Z-b0101/zb-flight-model/program/MASS_ROLLUP.md

# Stacked mass / CG / SM roll-up (CE-01 freeze input)

Generated by `scripts/mass_rollup.py` from `cad/params.json` (design + structure blocks). **Mass baseline locked (proposed): 211.9 g planning, CG 128.5 mm.** NP 142.56 mm (twin VLM, as computed by the script; every SM in this file comes from the script). Static-margin floor 5.0%; band 5–8%.

## Case 1: all changes + a 17 g motor, no trim levers

| Step | Mass (g) | CG (mm) | SM |
| --- | --- | --- | --- |
| Planning baseline (locked) | 211.9 | 128.50 | 7.03% |
| R2 hinge-line web | 212.7 | 128.95 | 6.81% |
| R3 mid-chord web | 214.2 | 129.53 | 6.52% |
| Web glue | 214.7 | 129.77 | 6.40% |
| R4 hatch frame/tray/lid (net) | 216.2 | 129.15 | 6.70% |
| R5 centre section (net) | 217.7 | 128.81 | 6.87% |
| DR-01 tip fins | 219.7 | 131.10 | 5.73% |
| Motor delta (17 g vs 10 g) | 226.7 | 132.98 | 4.79% **below 5% floor** |

## Case 2: same + battery 3 mm forward (current hatch limit) + ESC moved next to the FC (185 → 95 mm)

| Step | Mass (g) | CG (mm) | SM |
| --- | --- | --- | --- |
| Planning baseline (locked) | 211.9 | 128.50 | 7.03% |
| R2 hinge-line web | 212.7 | 128.95 | 6.81% |
| R3 mid-chord web | 214.2 | 129.53 | 6.52% |
| Web glue | 214.7 | 129.77 | 6.40% |
| R4 hatch frame/tray/lid (net) | 216.2 | 129.15 | 6.70% |
| R5 centre section (net) | 217.7 | 128.81 | 6.87% |
| DR-01 tip fins | 219.7 | 131.10 | 5.73% |
| Motor delta (17 g vs 10 g) | 226.7 | 132.98 | 4.79% **below 5% floor** |
| Battery 3 mm forward | 226.7 | 132.16 | 5.20% |
| ESC moved to 95 mm | 226.7 | 130.77 | 5.90% |

## Sensitivity: final SM vs motor mass (with both levers)

| Motor mass (g) | AUW (g) | CG (mm) | SM |
| --- | --- | --- | --- |
| 10 | 219.7 | 128.82 | 6.87% |
| 12 | 221.7 | 129.39 | 6.59% |
| 14 | 223.7 | 129.95 | 6.31% |
| 17 | 226.7 | 130.77 | 5.90% |
| 19 | 228.7 | 131.30 | 5.63% |
| 20 | 229.7 | 131.57 | 5.50% |
| 25 | 234.7 | 132.86 | 4.85% |

**Reading:** without trim levers, a 17 g motor takes SM below the 5% floor (4.79%). Moving the battery 3 mm forward and relocating the ESC next to the FC restores 5.90%. Rule for the R-07 pick: stacked SM ≥ 5.5% using only those two levers, i.e. motor ≤ 19 g strictly (20 g gives 5.496%, just under the line). Ballast is a last resort. MBSE records the acceptance at CE-01.

**Correction (2026-10-14, MBSE independent verification):** the sensitivity table was earlier hand-computed with NP 142.6 mm. It is now regenerated from the script (NP 142.56 mm): about −0.02 points across the column, and 20 g gives 5.496% (shown rounded as 5.50%), not 5.52%.

**Superseded for the R-07 pick:** the motor-only cap above does not include the prop, the prop adapter or the DR-14 notch. The full R-07 power-train stack gives SM 4.58% with both levers and needs a CG lever. See `mfg/MOTOR_TRADE.md` §6 on `r07/motor-trade` (PR #14).
