Z-b0101/zb-flight-model/program/README.md

# Z!B Program — System of Record

This folder holds the program's controlled documents — the files the Z!B team
actually runs on. Pushed 2026-10-13 by Oubi (outgoing GM) per CEO direction,
as part of the acting-GM handover to Claude.

**Start here:** `DEV_TRACKER.md` — the system of record. Everything else hangs off it.
**Document register:** `ZIB_DOCUMENT_REGISTER.md` — what each file is, who owns it, its status.

| File | What it is |
|---|---|
| DEV_TRACKER.md | System of record: decisions, work packages, gates, open items |
| DESIGN_PHILOSOPHY.md | The 8 principles the program runs on |
| RISK_REGISTER.md | 15 open risks + mitigations (living) |
| WEIGHT_BUDGET.md | Gram-by-gram budget; 46g margin (living) |
| BUDGET.md | $10K program budget, phased spend (living) |
| CE_COLLABORATION_PROCESS.md | Inbox protocol (authorship lines, tags, SLA) |
| ZIB_DOCUMENT_REGISTER.md | Register of all program documents |
| AIRFOIL_TRADE.md | MH60 selection study |
| ITERATION_LOG.md | A2 optimization loop (4 cycles, converged) |
| GITHUB_TRACEABILITY.md | 40-claim audit: 55% backed / 40% partial / 5% gap |
| AERO_OPTIMIZATION.md | Aero optimization study |
| AIRFRAME_ARCHITECTURES.md | 16-source architecture survey |
| MATERIALS.md | Materials audit |
| HOTEL_LOAD_PLAN.md | Hotel-load measurement plan |
| VERIFICATION_MATRIX.md | Requirements → verification (26 RQs, DAL E) |
| TDR_RECORD.md | Twin Design Review record (verdict: proceed with actions) |
| FHA.md | Functional Hazard Assessment (ARP4761-lite, 5J envelope) |
| DESIGN_CLOSURE.md | Design closure record |
| MBSE_FRAMEWORK.md | Model-based systems engineering framework |
| SAE_ALIGNMENT.md | ARP4754A tailoring alignment |
| WILD_CONCEPTS.md | E1/E2/E3 concept proposals |
| ZIB_MASTER_PACKAGE.md | Distributable snapshot (draft) |
| ZIB_OPERATING_SYSTEM.md | Behavior handbook (CEO-held) |
| reviews/INHERITED_BASELINE_AUDIT_2026-10-13.md | Y3k's Day 1–2 baseline audit |

**Rules:** These files are the truth. Update them in place; never rewrite history
(DEV_TRACKER is append-only). The handover narrative + program-system YAML live
with the CEO, not here — this folder is the evidence, not the story.
