Z-b0101/zb-flight-model/program/handover/README.md

# Handover notes (Constitution Art III.6)

Written by the STF (`[STF — Claude]`) for each specialist seat.

Every note covers four things:
- the decisions in that lane
- the reasons behind them
- the traps already hit
- where the evidence lives (commit refs)

Notes are kept current. A note is a teaching record, not a design record. The frozen design is `cad/params.json` @ hash `479399d88b60`.

| Seat | Note | Status |
|---|---|---|
| AERO | `AERO.md` | Due 2026-10-15, 08:30 PT |
| ME | `ME.md` | Due 2026-10-15, 08:30 PT |
| SCM/MFG | `SCM_MFG.md` | Due 2026-10-15, 08:30 PT |
| CS | `CS.md` | Due 2026-10-15, 12:00 PT |
| PM | `PM.md` | Due 2026-10-15, 12:00 PT |
| BIZ | `BIZ.md` (the numbers: what is measured, modelled or provisional) | Due 2026-10-15, 12:00 PT |
| HR | `HR.md` (seats, tags, access history) | Due 2026-10-15, 12:00 PT |
