Z-b0101/zb-flight-model/reports/ZB-ER-001/figures/A-4.png

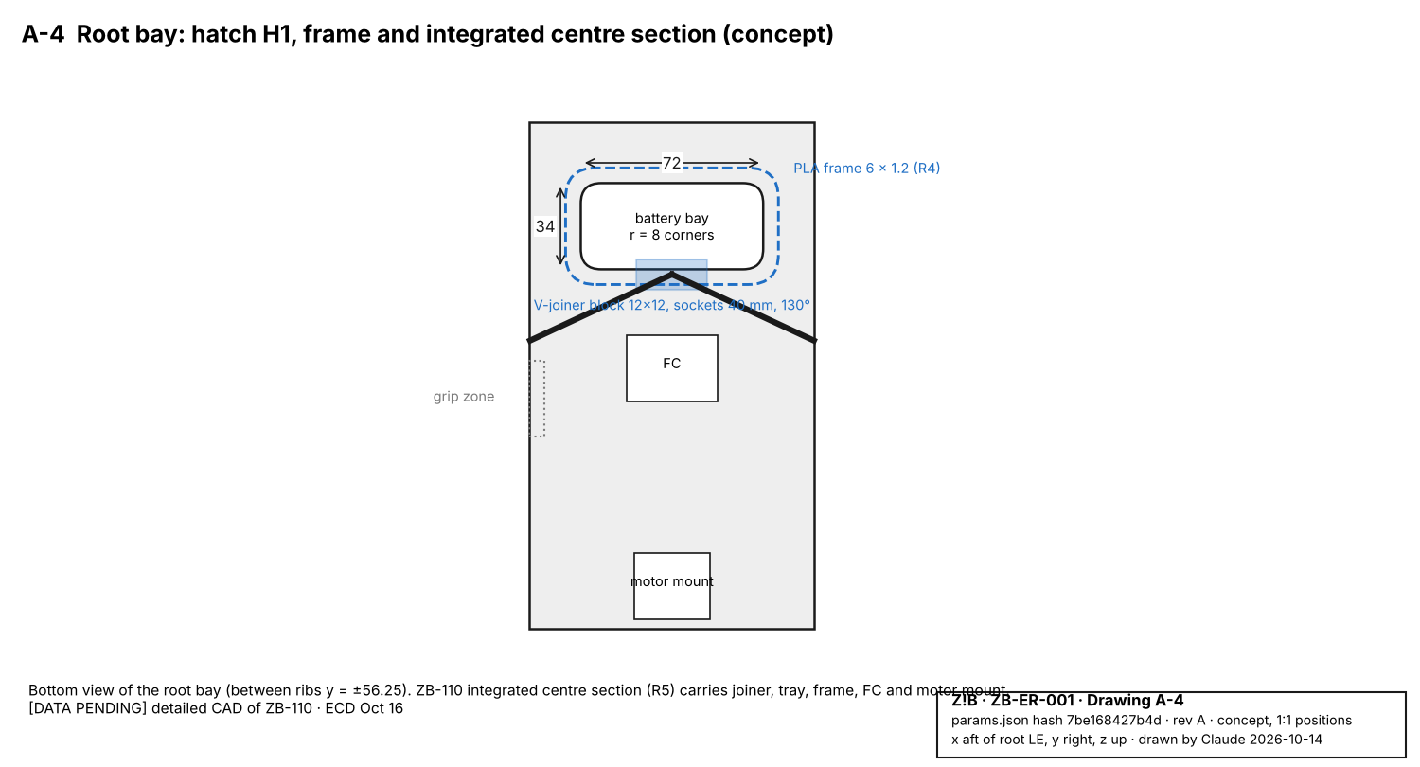
reports/ZB-ER-001/figures/A-4.png
