Z-b0101/zb-flight-model/reports/ZB-ER-001/figures/B-3.png

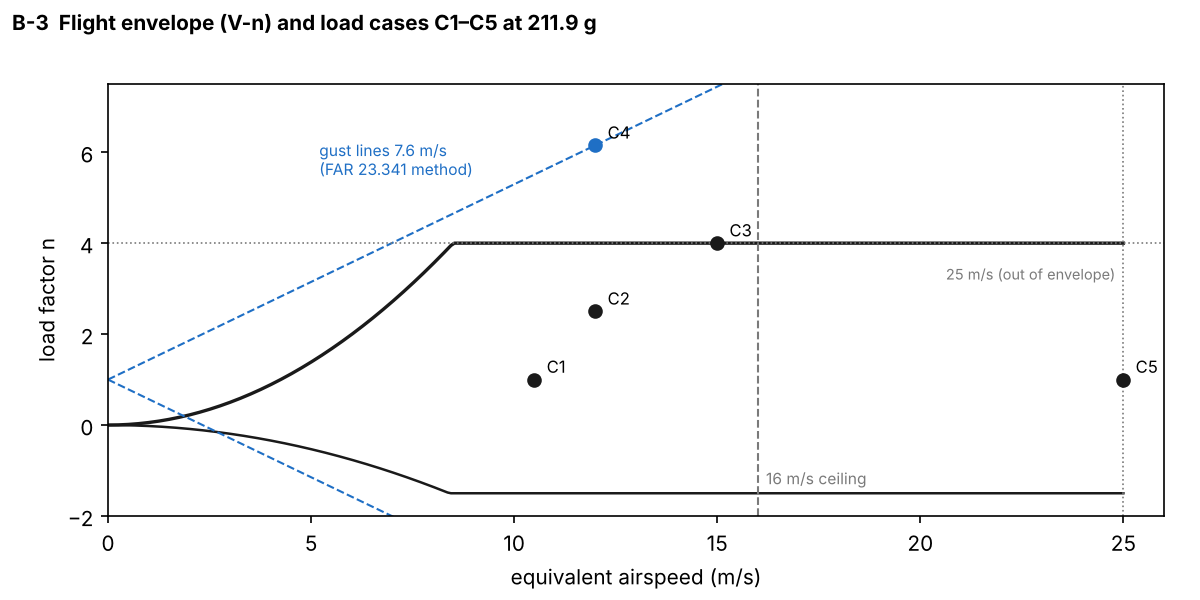
reports/ZB-ER-001/figures/B-3.png
