Z-b0101/zb-flight-model/cad/assembly.stl

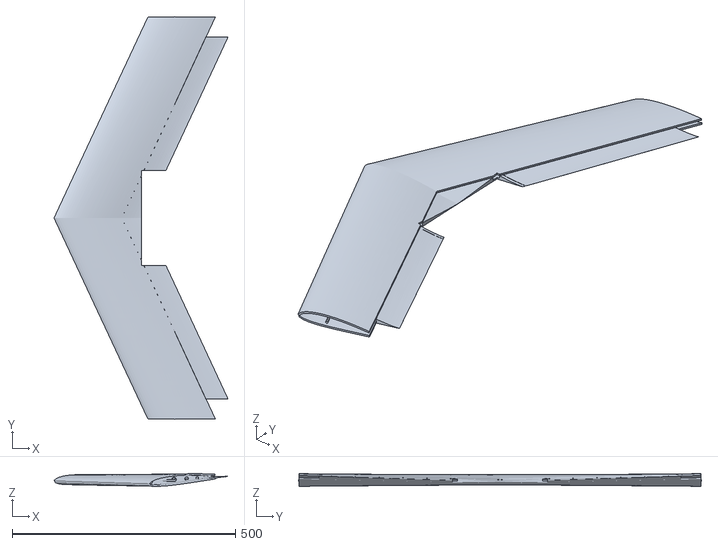
[picture p24: CAD file, 2026-10-15]
cad/assembly.stl
389.7 x 902.7 x 28.4
