Z-b0101/zb-flight-model/cad/assembly_full.stl

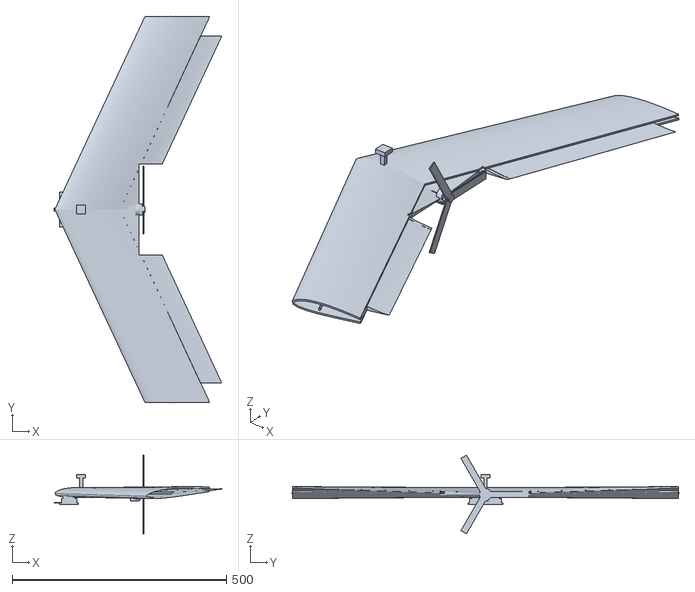
[picture p25: CAD file, 2026-10-15]
cad/assembly_full.stl
391.3 x 902.7 x 183.5
