Z-b0101/zb-flight-model/cad/parts/avionics/rx.stl

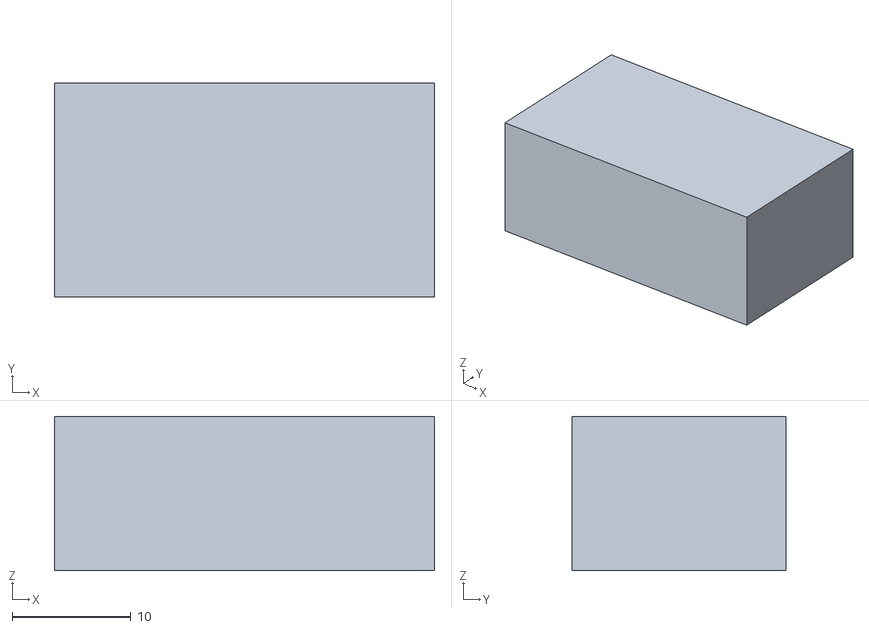
[picture p26: CAD file, 2026-10-15]
cad/parts/avionics/rx.stl
32.0 x 18.0 x 13.0
