Z-b0101/zb-flight-model/cad/parts/hatch/tray_port.stl

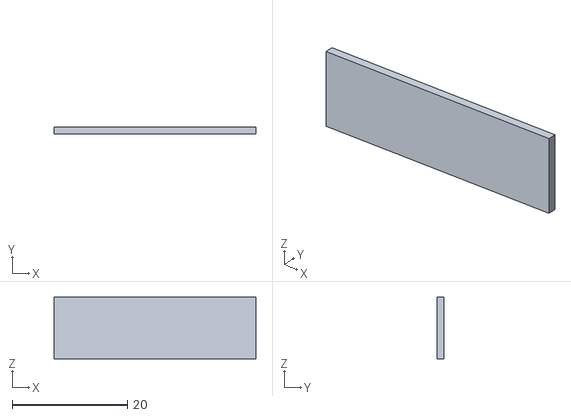
[picture p27: CAD file, 2026-10-15]
cad/parts/hatch/tray_port.stl
35.0 x 1.20 x 10.7
