Z-b0101/zb-flight-model/cad/parts/power/battery.stl

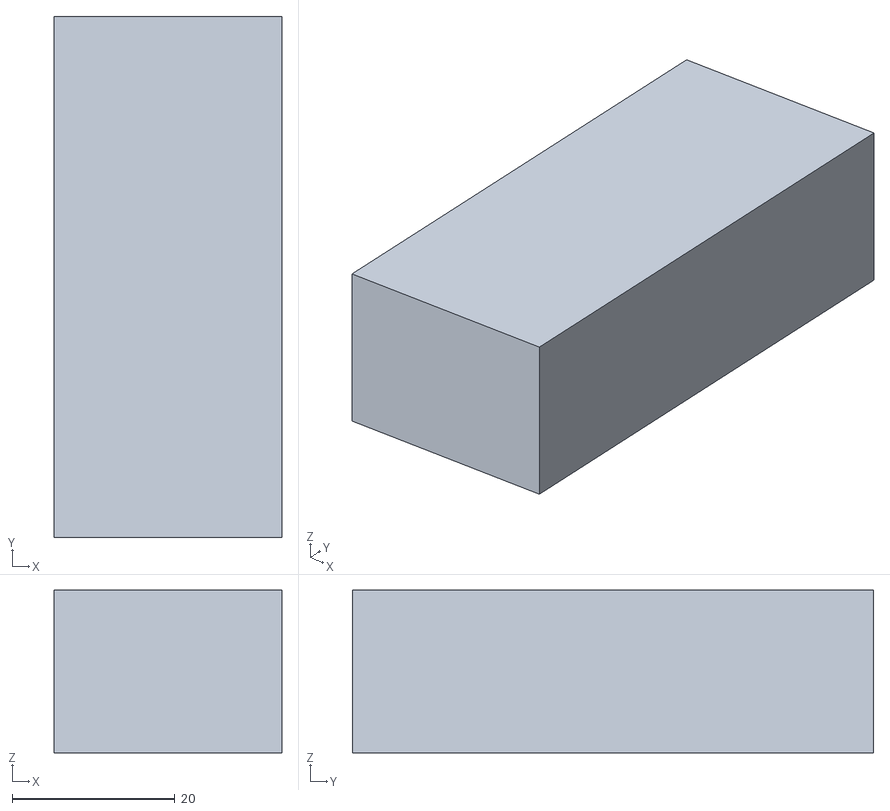
[picture p28: CAD file, 2026-10-15]
cad/parts/power/battery.stl
28.0 x 64.0 x 20.0
