Z-b0101/zb-flight-model/cad/parts/propulsion/propulsion.stl

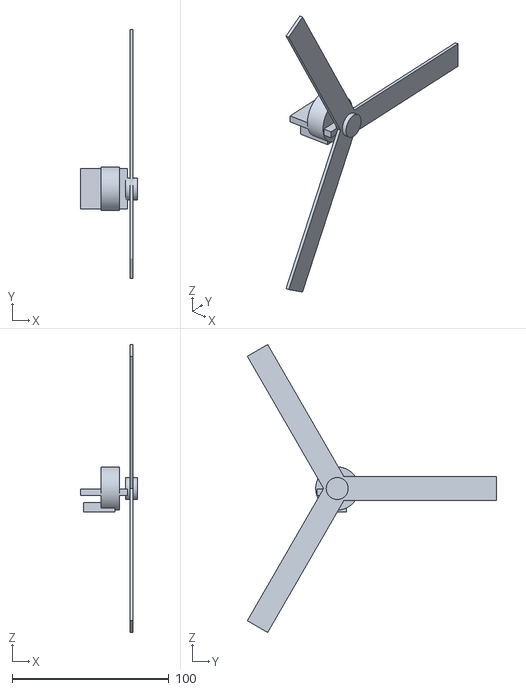
[picture p29: CAD file, 2026-10-15]
cad/parts/propulsion/propulsion.stl
36.4 x 158.9 x 183.5
