Z-b0101/zb-flight-model/cad/parts/wing_structure/skin_top.stl

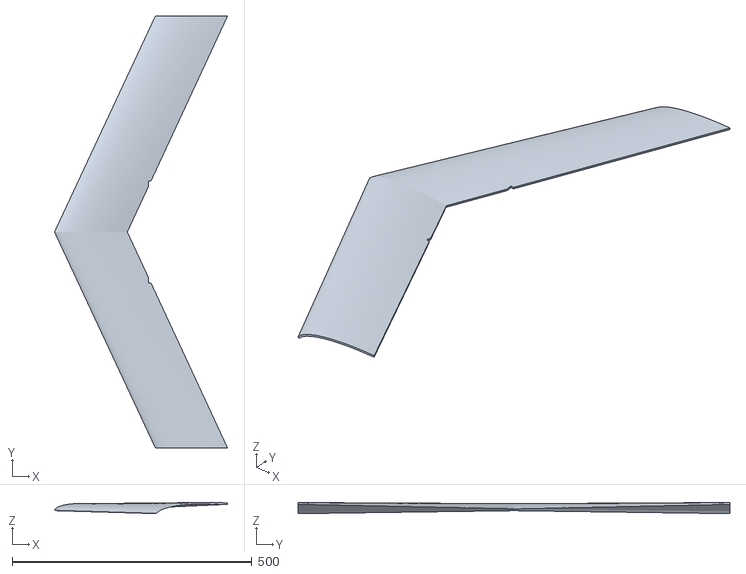
[picture p30: CAD file, 2026-10-15]
cad/parts/wing_structure/skin_top.stl
360.7 x 900.0 x 23.7
