Z-b0101/zb-flight-model/cad/parts/wiring/w1b.stl

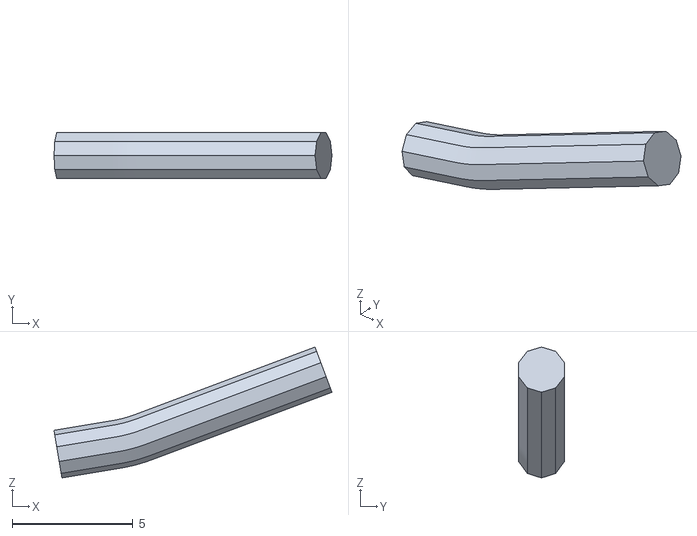
[picture p31: CAD file, 2026-10-15]
cad/parts/wiring/w1b.stl
11.5 x 1.90 x 5.42
