Z-b0101/zb-flight-model/cad/spar.stl

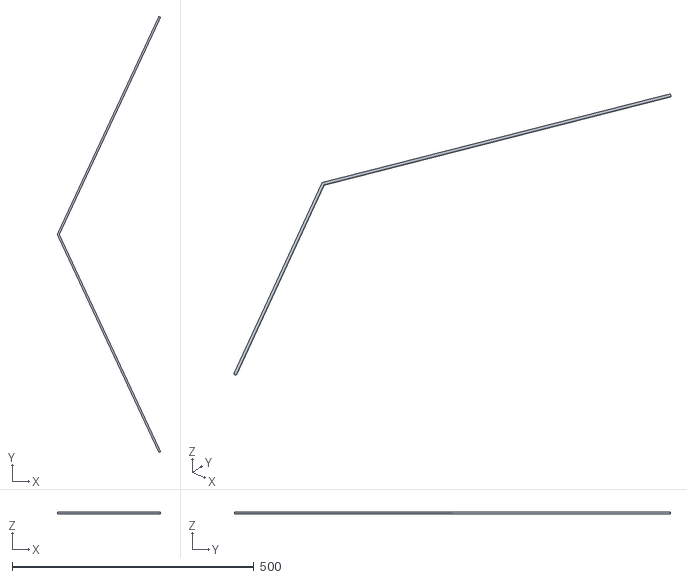
[picture p32: CAD file, 2026-10-15]
cad/spar.stl
213.7 x 902.7 x 4.00
