Z-b0101/zb-flight-model/cad/elevon_right.stl

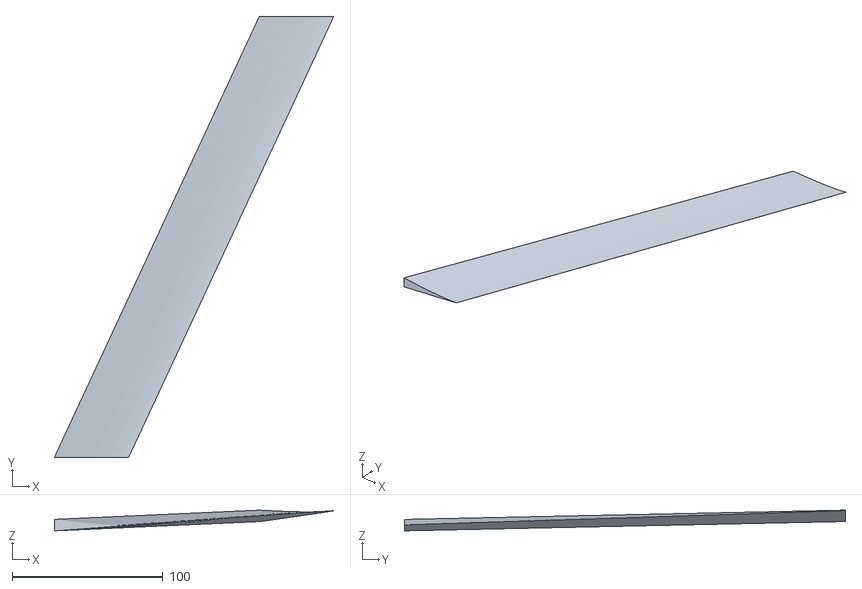
[picture p33: CAD file, 2026-10-15]
cad/elevon_right.stl
185.4 x 292.5 x 13.7
