Z-b0101/zb-flight-model/cad/parts/avionics/encoder.stl

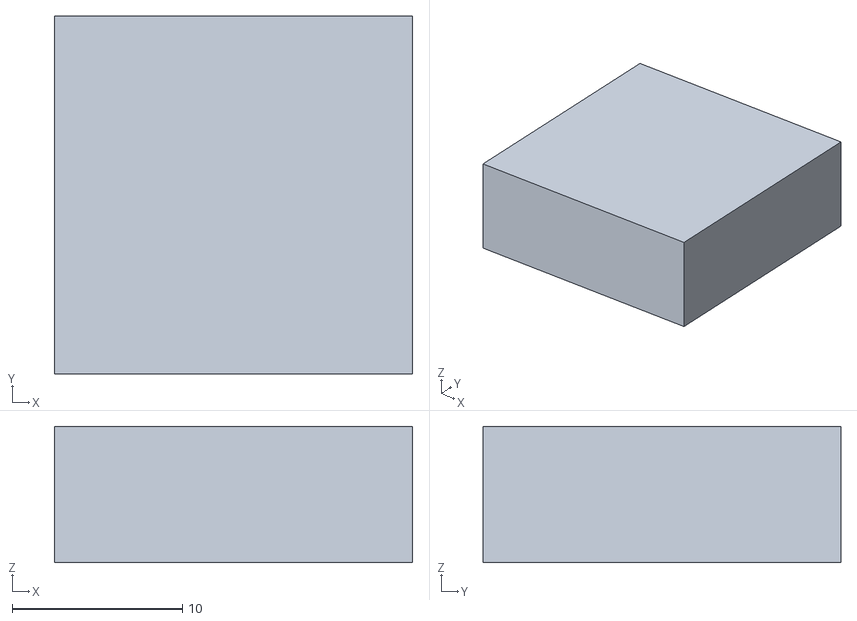
[picture p34: CAD file, 2026-10-15]
cad/parts/avionics/encoder.stl
21.0 x 21.0 x 8.00
