Z-b0101/zb-flight-model/cad/parts/hatch/tray_fwd.stl

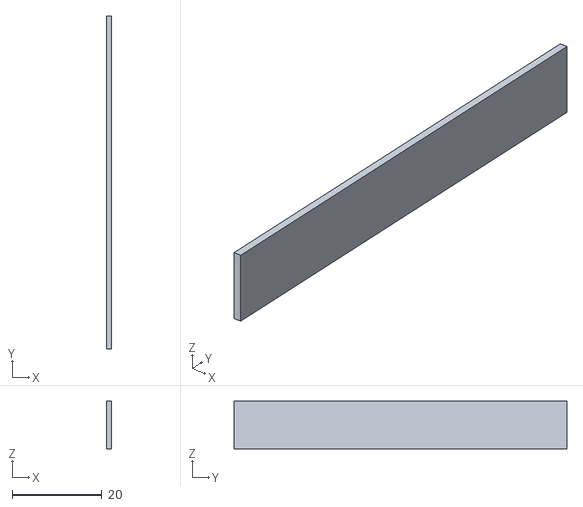
[picture p35: CAD file, 2026-10-15]
cad/parts/hatch/tray_fwd.stl
1.20 x 74.4 x 10.7
