Z-b0101/zb-flight-model/cad/parts/propulsion/prop.stl

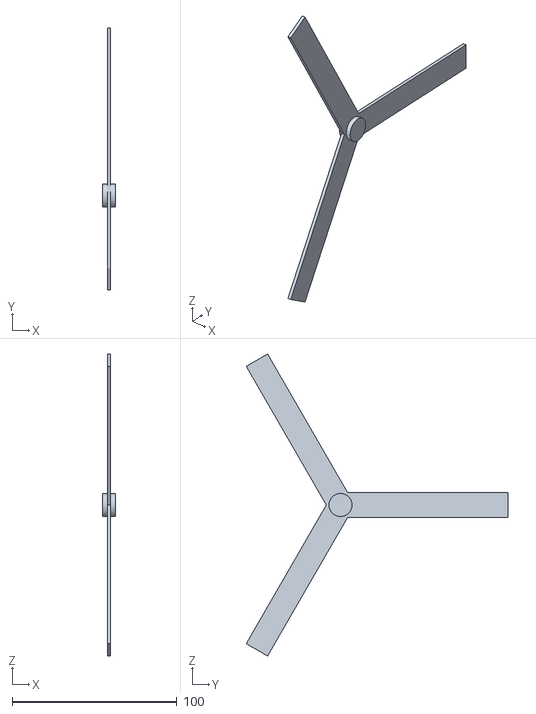
[picture p36: CAD file, 2026-10-15]
cad/parts/propulsion/prop.stl
7.62 x 158.9 x 183.5
