Z-b0101/zb-flight-model/cad/parts/wiring/wiring.stl

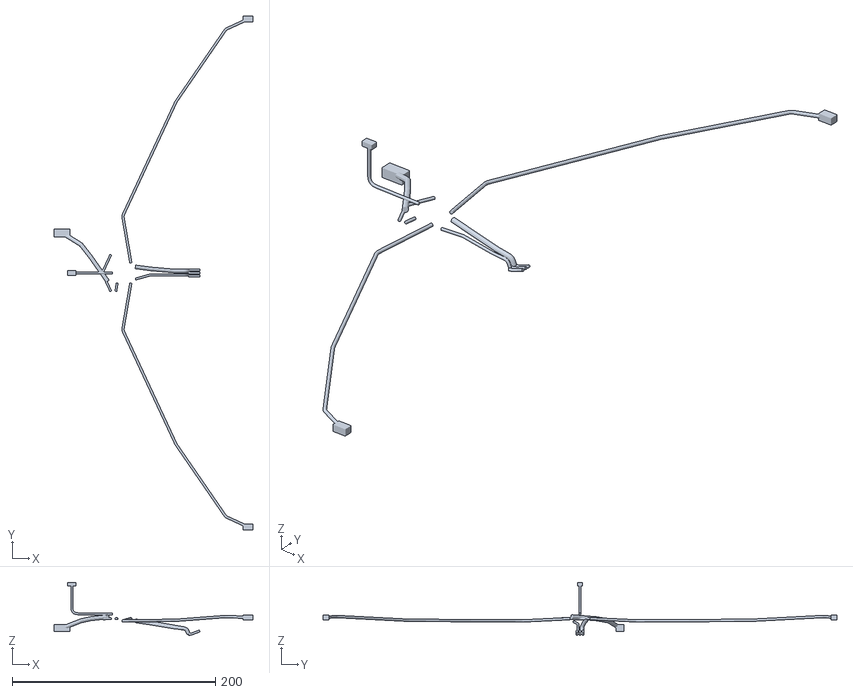
[picture p37: CAD file, 2026-10-15]
cad/parts/wiring/wiring.stl
196.0 x 506.0 x 52.2
