Z-b0101/zb-flight-model/cad/parts/avionics/avionics.stl

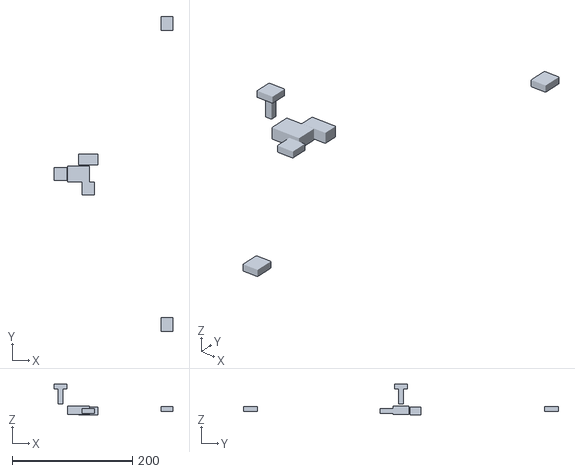
[picture p38: CAD file, 2026-10-15]
cad/parts/avionics/avionics.stl
196.9 x 523.2 x 50.8
