Z-b0101/zb-flight-model/cad/parts/hatch/latch_1.stl

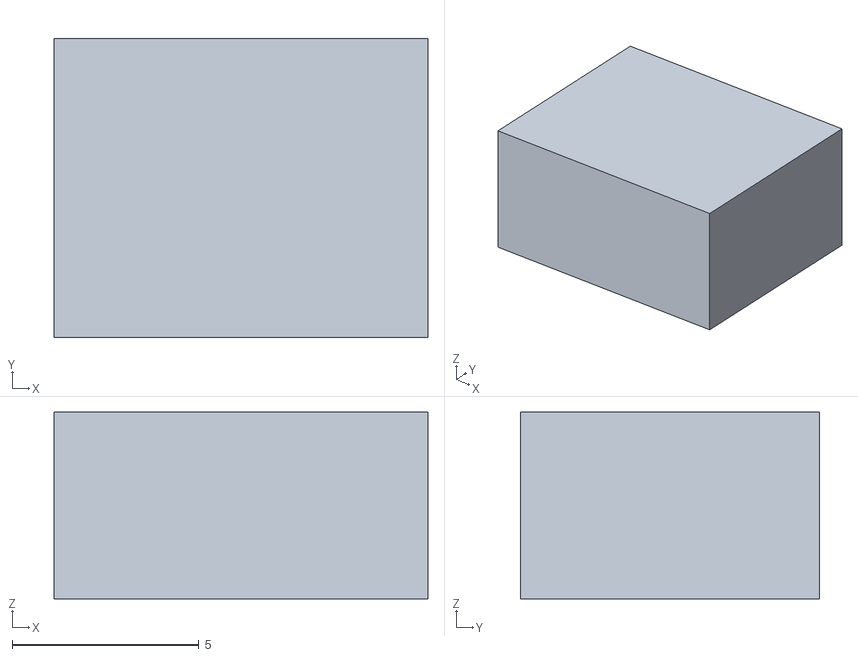
[picture p39: CAD file, 2026-10-15]
cad/parts/hatch/latch_1.stl
10.0 x 8.00 x 5.00
