Z-b0101/zb-flight-model/cad/parts/propulsion/motor_mount.stl

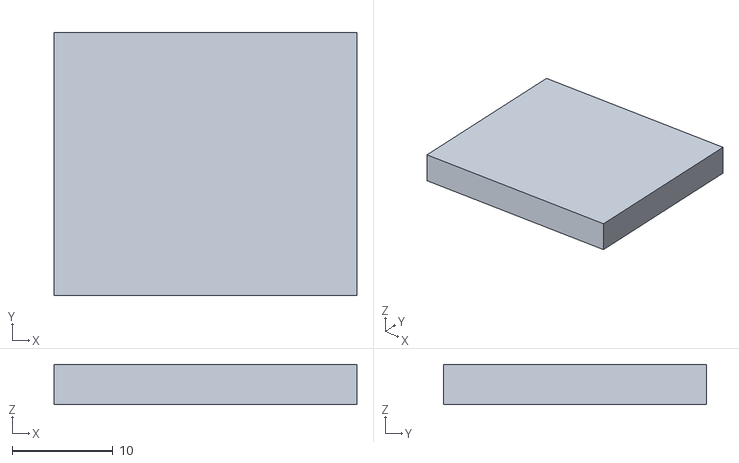
[picture p40: CAD file, 2026-10-15]
cad/parts/propulsion/motor_mount.stl
30.0 x 26.0 x 4.00
