Z-b0101/zb-flight-model/cad/parts/wing_structure/wing_structure.stl

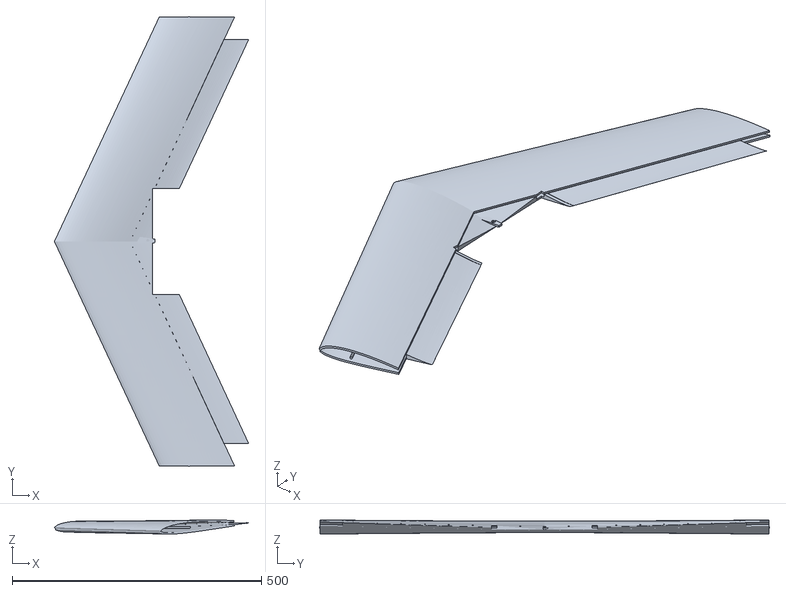
[picture p41: CAD file, 2026-10-15]
cad/parts/wing_structure/wing_structure.stl
389.7 x 902.7 x 28.4
