Z-b0101/zb-flight-model/cad/parts/wiring/w5_gps.stl

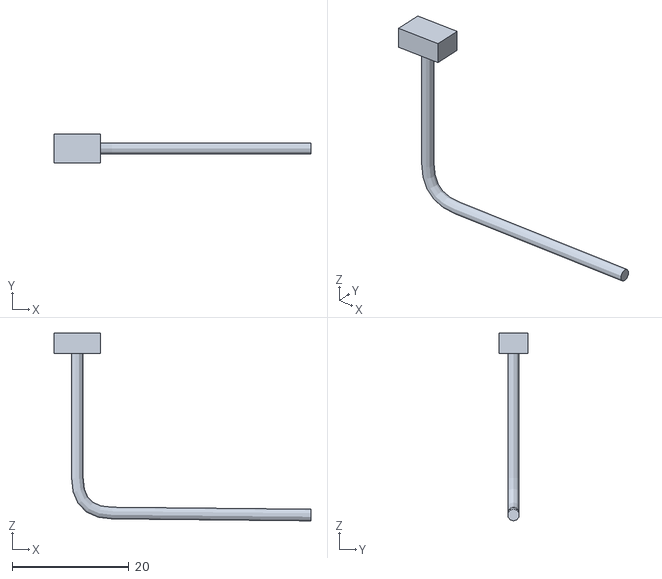
[picture p42: CAD file, 2026-10-15]
cad/parts/wiring/w5_gps.stl
44.0 x 5.00 x 32.1
