Z-b0101/zb-flight-model/cad/parts/hatch/lid.stl

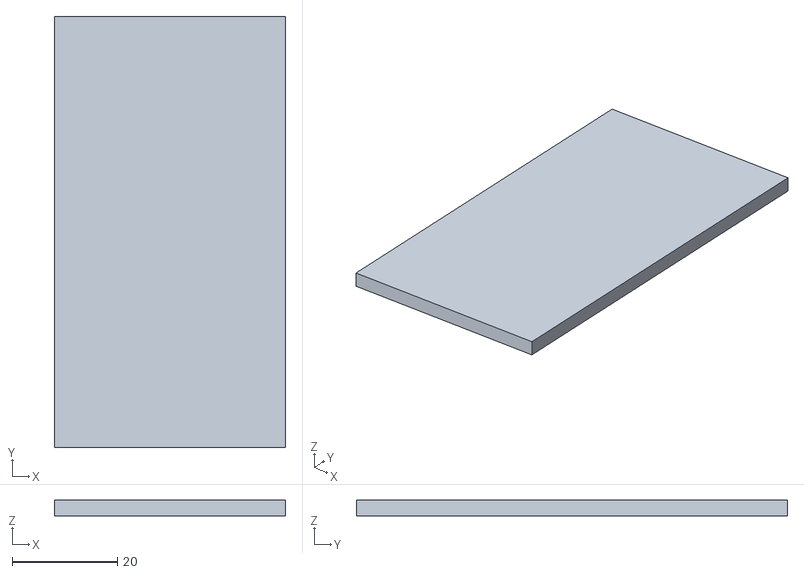
[picture p43: CAD file, 2026-10-15]
cad/parts/hatch/lid.stl
44.0 x 82.0 x 3.00
