Z-b0101/zb-flight-model/cad/parts/propulsion/motor.stl

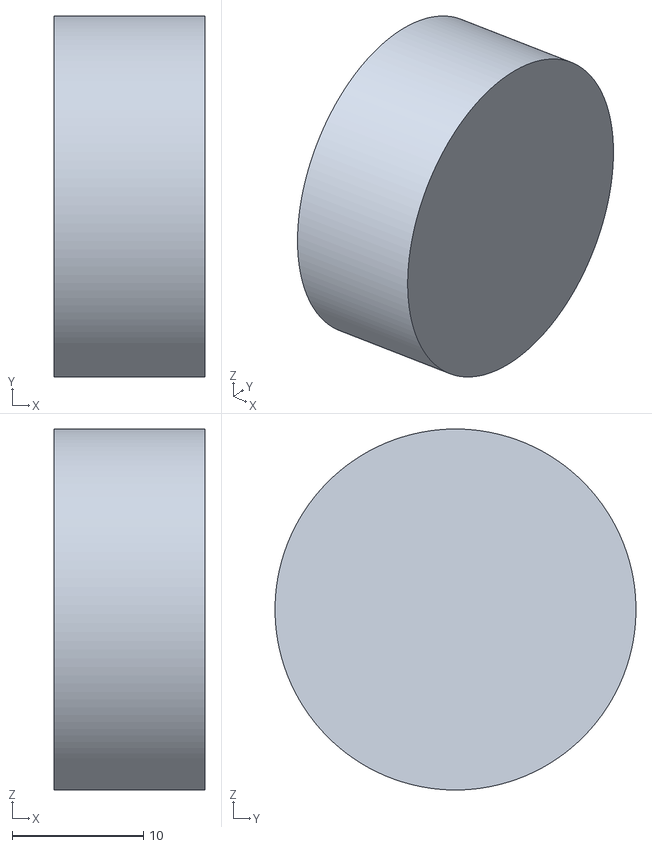
[picture p44: CAD file, 2026-10-15]
cad/parts/propulsion/motor.stl
11.5 x 27.5 x 27.5
