Z-b0101/zb-flight-model/cad/parts/wing_structure/rib.stl

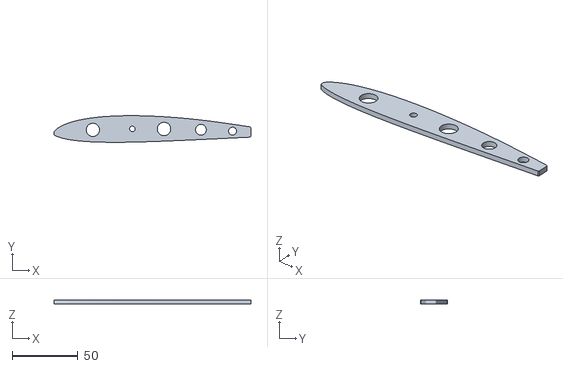
[picture p45: CAD file, 2026-10-15]
cad/parts/wing_structure/rib.stl
149.5 x 20.2 x 3.00
