Z-b0101/zb-flight-model/cad/parts/wiring/w6_rx_enc.stl

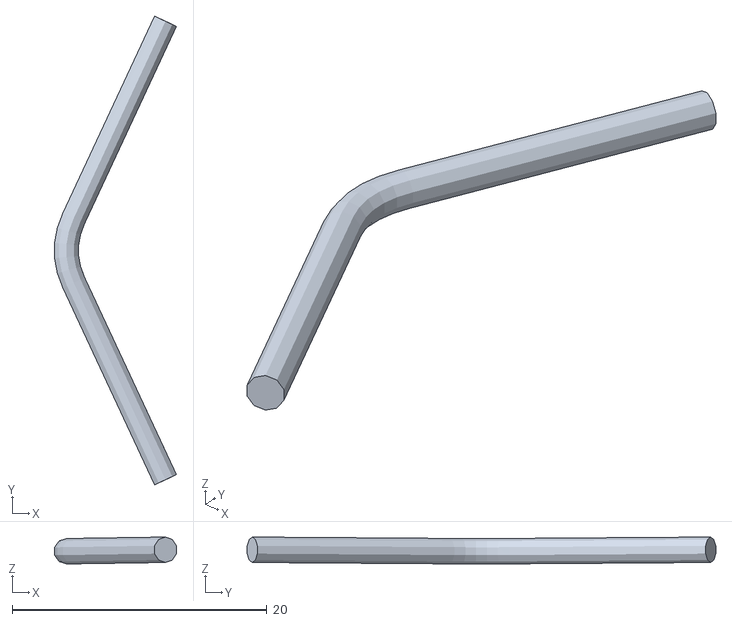
[picture p46: CAD file, 2026-10-15]
cad/parts/wiring/w6_rx_enc.stl
9.58 x 36.8 x 2.12
