Z-b0101/zb-flight-model/cad/parts/avionics/servo_R.stl

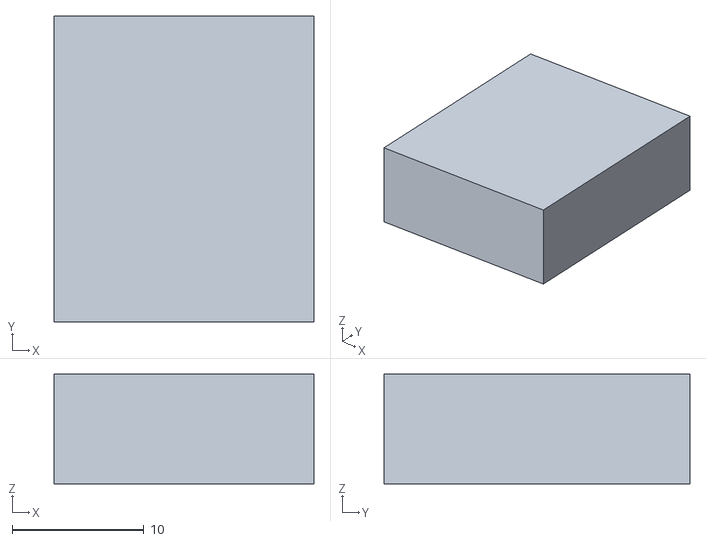
[picture p47: CAD file, 2026-10-15]
cad/parts/avionics/servo_R.stl
19.7 x 23.2 x 8.34
