Z-b0101/zb-flight-model/cad/parts/propulsion/esc.stl

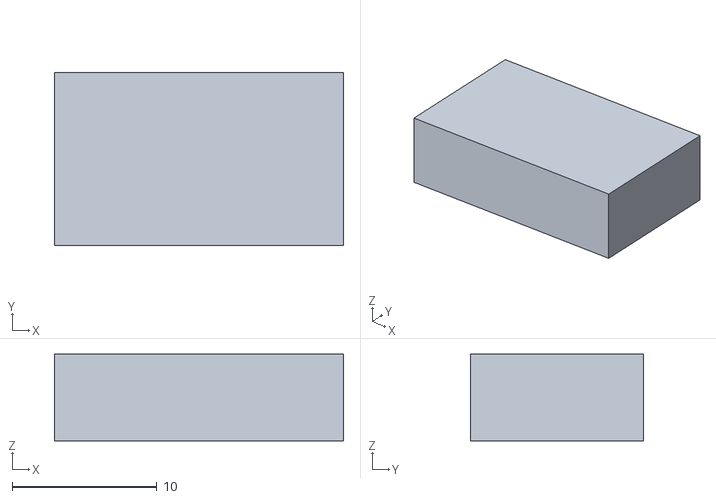
[picture p48: CAD file, 2026-10-15]
cad/parts/propulsion/esc.stl
20.0 x 12.0 x 6.00
