Z-b0101/zb-flight-model/cad/te_centre.stl

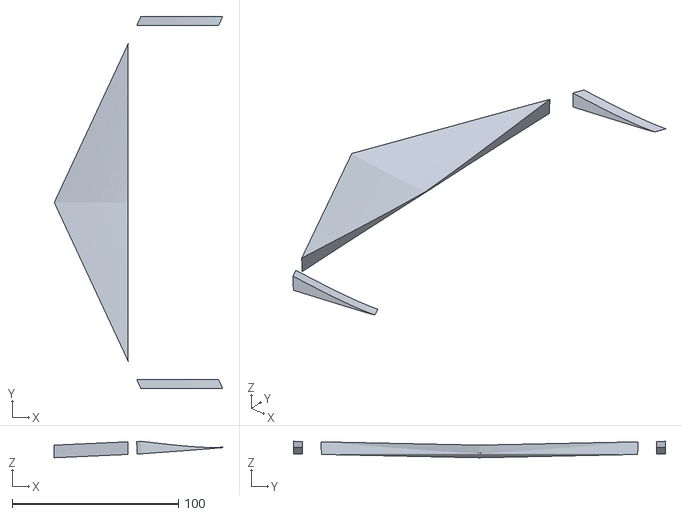
[picture p49: CAD file, 2026-10-15]
cad/te_centre.stl
101.5 x 224.0 x 9.96
