Z-b0101/zb-flight-model/cad/parts/wiring/w3b_signal.stl

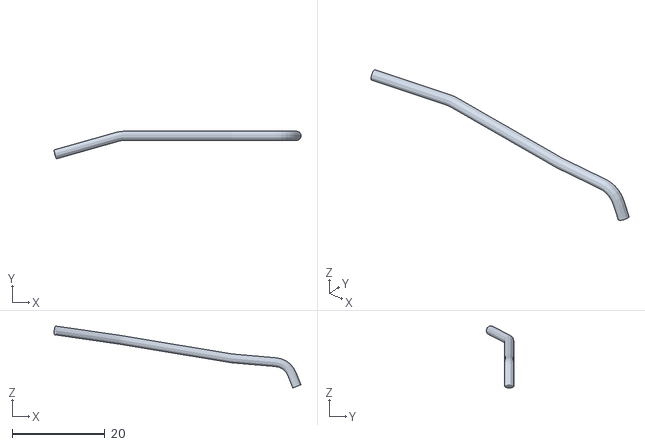
[picture p50: CAD file, 2026-10-15]
cad/parts/wiring/w3b_signal.stl
53.4 x 5.96 x 13.4
