Z-b0101/zb-flight-model/cad/parts/avionics/fc.stl

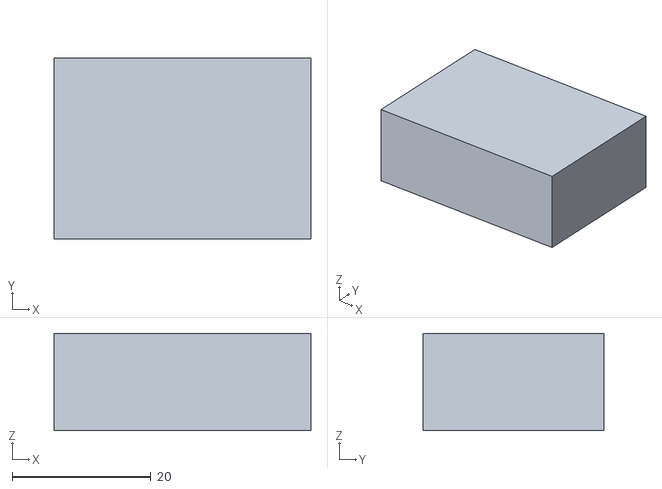
[picture p51: CAD file, 2026-10-15]
cad/parts/avionics/fc.stl
37.0 x 26.0 x 14.0
