Z-b0101/zb-flight-model/cad/parts/hatch/hinge.stl

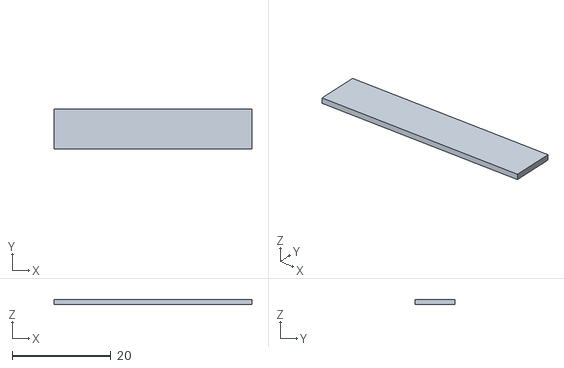
[picture p52: CAD file, 2026-10-15]
cad/parts/hatch/hinge.stl
40.0 x 8.00 x 1.00
