Z-b0101/zb-flight-model/cad/parts/wiring/w4_servo_R.stl

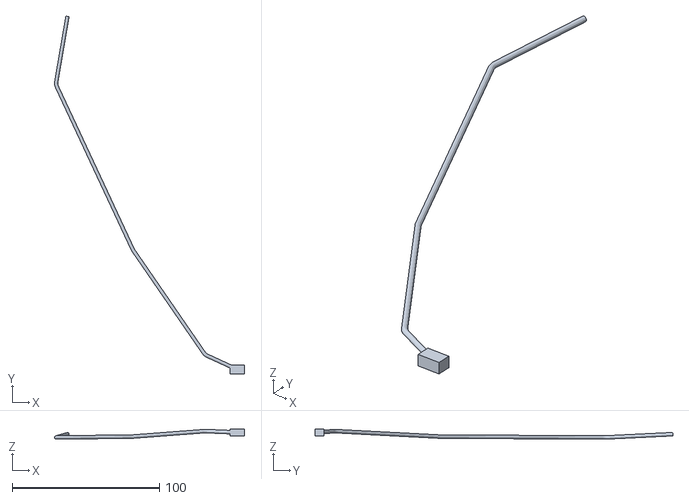
[picture p53: CAD file, 2026-10-15]
cad/parts/wiring/w4_servo_R.stl
129.1 x 243.2 x 7.13
