Z-b0101/zb-flight-model/cad/parts/avionics/gps_mast.stl

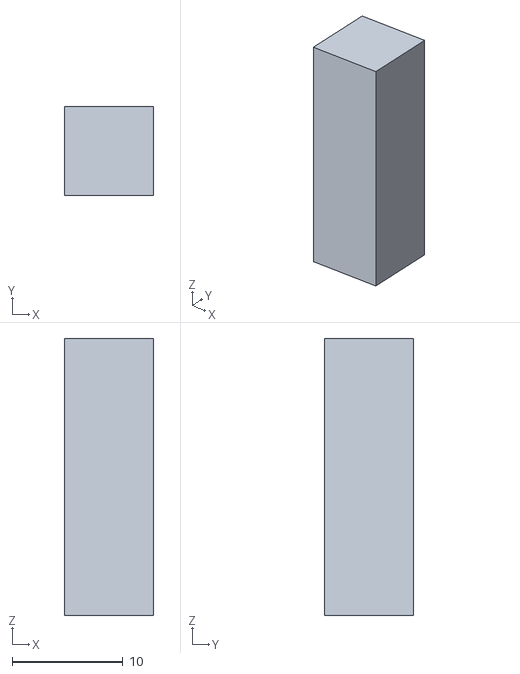
[picture p54: CAD file, 2026-10-15]
cad/parts/avionics/gps_mast.stl
8.00 x 8.00 x 25.0
