Z-b0101/zb-flight-model/cad/parts/wing_structure/skin_bottom.stl

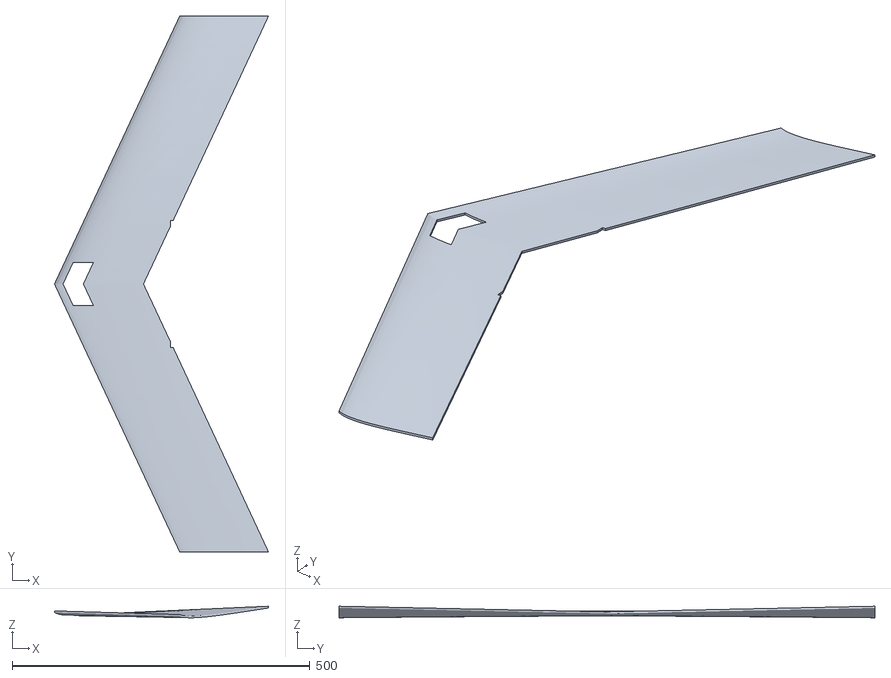
[picture p55: CAD file, 2026-10-15]
cad/parts/wing_structure/skin_bottom.stl
359.5 x 900.0 x 19.5
