Z-b0101/zb-flight-model/cad/parts/wiring/w3a_power.stl

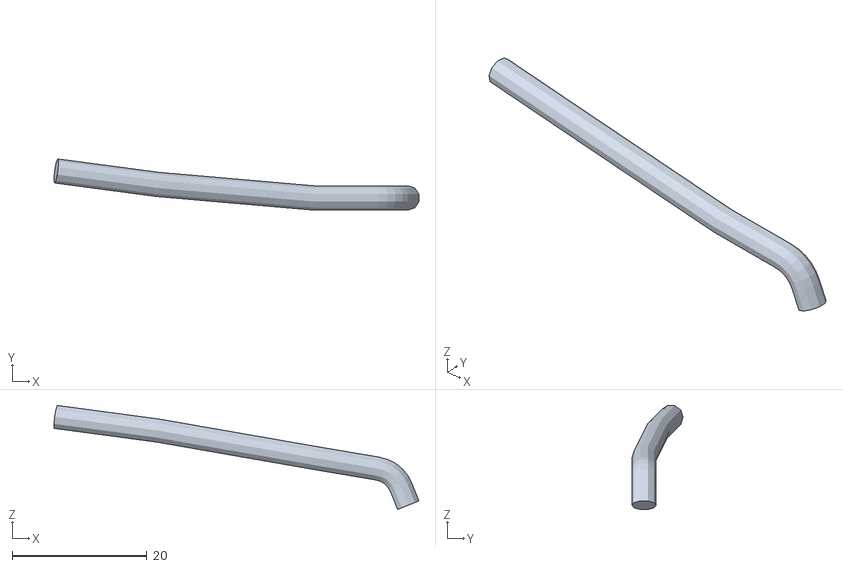
[picture p56: CAD file, 2026-10-15]
cad/parts/wiring/w3a_power.stl
54.1 x 7.58 x 15.4
