Z-b0101/zb-flight-model/cad/parts/hatch/hatch.stl

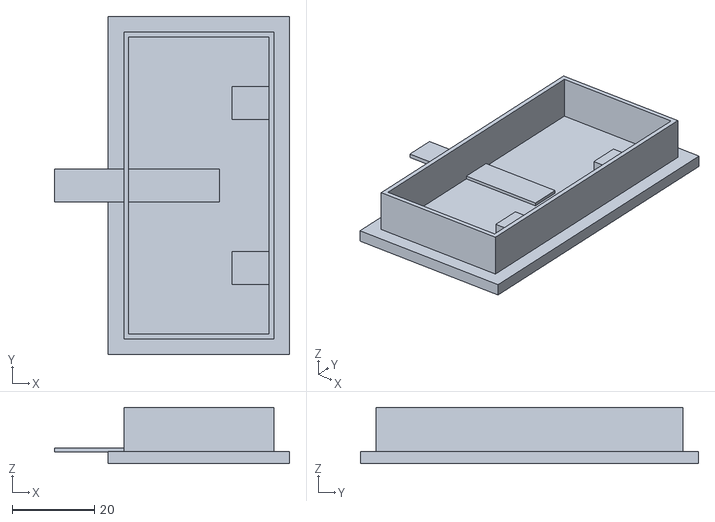
[picture p57: CAD file, 2026-10-15]
cad/parts/hatch/hatch.stl
57.0 x 82.0 x 13.7
