Z-b0101/zb-flight-model/cad/parts/wiring/w2_batt_fc.stl

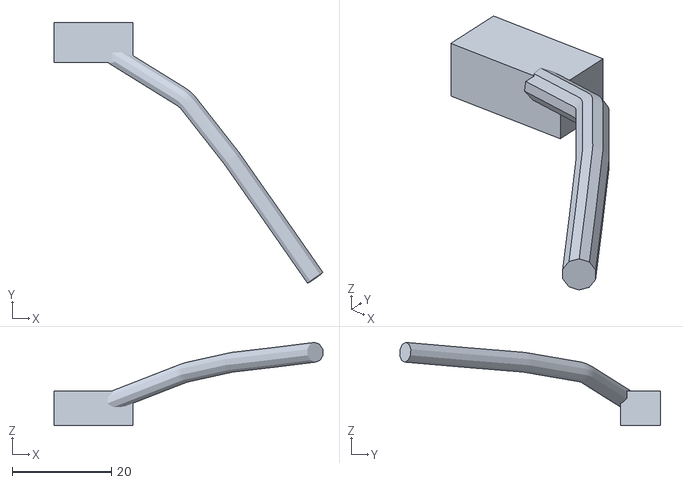
[picture p58: CAD file, 2026-10-15]
cad/parts/wiring/w2_batt_fc.stl
54.3 x 52.6 x 16.8
