Z-b0101/zb-flight-model/cad/parts/wiring/w6_enc_fc.stl

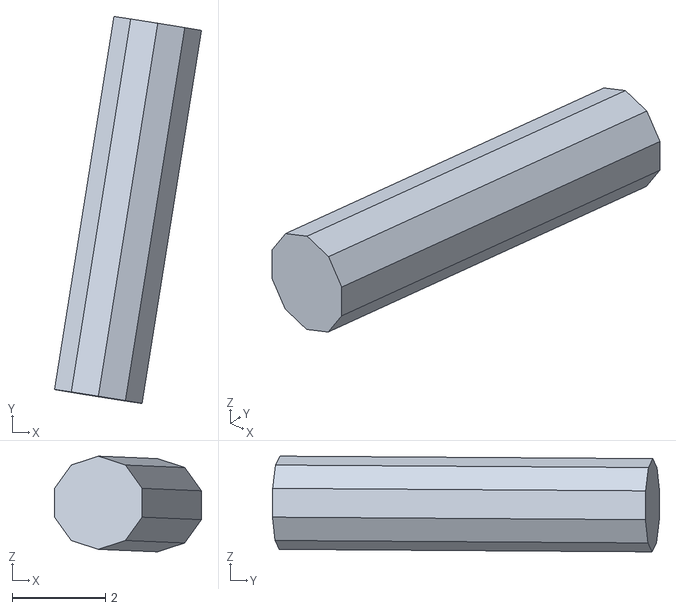
[picture p59: CAD file, 2026-10-15]
cad/parts/wiring/w6_enc_fc.stl
3.15 x 8.30 x 2.05
