Z-b0101/zb-flight-model/(list of files, cad)

Other CAD files:
cad/twin/model.obj
cad/parts/power/power.stl
cad/elevon_left.stl
cad/parts/avionics/gps.stl
cad/parts/hatch/tray_aft.stl
cad/parts/wing_structure/elevon_left.stl
cad/parts/wiring/w1a.stl
cad/parts/avionics/servo_L.stl
cad/parts/hatch/tray_stbd.stl
cad/parts/hatch/latch_2.stl
cad/parts/wiring/w1c.stl
cad/parts/wiring/w4_servo_L.stl
