Z-b0101/zb-flight-model/mfg/CALIBRATION_BUY.md

# Calibration buy: parts cart (draft for order by Fri Oct 16)

**Owner:** Claude (GM). **Spend authority:** GM up to $500 (D-23); the CEO places the orders (agents cannot pay).
**Prices checked:** 2026-10-14 on the shop pages linked below. Stock was not always shown; check at checkout.

## One finding first: hold the motor, ESC and propeller (R-07)
The planned **HGLRC Specter 1404 4800KV** is rated by its seller for **2.5–4 inch props, 15.1 A max** ([WREKD](https://wrekd.com/products/hglrc-specter-1404-4800kv-micro-motor)). The design swings a **7-inch** prop. R-07 has questioned this pairing since Oct 12.

A first estimate (assumed prop and motor constants, to be confirmed on the bench) gives:

| Motor class (all on 7040-3, 3S) | Cruise 4 W shaft | Climb 15 W shaft | Full throttle |
|---|---|---|---|
| 1404 4800KV (planned, 10 g) | 4.7 A, motor eff. ~0.60 | 11.5 A, ~0.49 | **~66 A: burns out the motor and the 20 A ESC** |
| 1404 2750KV (10 g) | 2.7 A, ~0.75 | 6.6 A, ~0.66 | ~33 A |
| ~1804 2000KV (~15–18 g) | 2.0 A, ~0.84 | 4.8 A, ~0.77 | ~22 A |
| ~2204 1400KV (~25 g) | 1.4 A, ~0.93 | 3.3 A, ~0.90 | ~14 A |

**What this means:** the planned motor would cruise but cannot be given full throttle without burning out. A lower-KV motor runs cooler and more efficiently, and could *raise* range. It costs 5–15 g of the 38 g weight margin.

**Plan:** I pick the motor/ESC/prop set by **Thu Oct 15 EOD**, with Oubi reviewing the mass and CG effect. The rest of the cart can be ordered now. The power-train items follow by Fri Oct 16, so the bench session (Oct 26–27) is unaffected.

## Cart: order now
| # | Item | Shop | Price (USD) | Note |
|---|---|---|---|---|
| 1 | SpeedyBee F405 WING APP Mini (flight controller) | [RaceDayQuads](https://racedayquads.com/products/speedybee-f405-wing-mini-2-6s-fixed-wing-flight-controller) | 43.49 | One DOA report in the wild: power it on the day it arrives |
| 2 | HGLRC M100-5883 GPS + compass | [RaceDayQuads](https://racedayquads.com/products/hglrc-m100-5883-gps-module-10th-gen) | 20.49 | Same shop as #1 (one shipment) |
| 3 | EMAX ES9051 servo ×2 | [ReadyMadeRC](https://www.readymaderc.com/products/details/emax-es9051-4-3g-digital-mini-servo) | 9.98 | In stock, $4.99 each |
| 4 | GNB 3S 650 mAh 80C XT30 LiPo ×1 | [Pyrodrone](https://pyrodrone.com/collections/3s-batteries/products/gaoneng-gnb-3s-11-1v-650mah-80c-lipo-battery-xt30) | 15.99 | In stock, 62 g, 20×28×64 mm (fits the hatch) |
| 5 | ToolkitRC WM150 watt meter | [Pyrodrone](https://pyrodrone.com/products/toolkitrc-wm150-advanced-watt-power-meter) | 51.99 | In stock; 10 mA precision, needed to measure the ~1 W electronics draw. Same shop as #4 |
| 6 | Depron 3 mm sheets (4) | [RcDepron.com](https://www.modelairplanenews.com/depron-foam-back-usa/) (US importer) | ~18 (est.) | Price not published; confirm at order |
| 7 | 4 mm OD carbon tube, 1 m (×2, one spare) | A vendor that **publishes flexural properties** (not an unspecified hobby tube) | ~14–25 (est.) | Must be 4.0 mm OD to fit the 4.2 mm rib slot. **Spec (SA-01 R1): flexural modulus ≥ 100 GPa, flexural strength ≥ 1 GPa.** A tube at the bottom of the published range (30 GPa / 250 MPa) fails the gust case. The spare is the coupon: 3-point bend before Gate 4 |
| 8 | PWM→PPM encoder | Amazon | ~4 (est.) | Only if the radio receiver has PWM outputs (R-09) |
| 9 | PLA filament, foam-safe CA, hot glue, hinge tape, pushrods | Amazon / local | ~28 (est.) | Commodity |
| 10 | 0.1 g kitchen scale | Amazon | ~12 (est.) | Skip if on hand |
| | **Subtotal, order now** | | **~$218** | Plus shipping from ~4 shops (est. $25–35) |

## Cart: order by Fri Oct 16 (after the R-07 decision)
| # | Item | Price (USD) | Note |
|---|---|---|---|
| 11 | Motor (choice from the table above) | ~17–25 | The planned Specter 1404 4800KV is also sold out at WREKD |
| 12 | 20 A ESC | ~12 | The EMAX Bullet 20A is **out of stock** at [GetFPV](https://www.getfpv.com/emax-d-shot-bullet-series-20a-esc-blheli-s.html); the substitute is chosen with the motor |
| 13 | Gemfan Flash 7040 3-blade, 4-pack | 5.49 | [GetFPV](https://www.getfpv.com/propellers/mini-quad-propellers/gemfan-flash-7040-durable-3-blade-propeller-set-of-4-clear.html), in stock, 7.9 g, 5 mm hub; confirm the hub fits the chosen motor shaft |
| | **Subtotal** | **~$35–43** | |

**Expected total: about $255–260 plus shipping (~$290 all-in), inside the $500 authority.**

## CEO answers (2026-10-14, 10:43 PT)
1. **No 0.1 g scale on hand:** #10 stays in the cart.
2. **RC radio on hand (photo, 10:44 PT): HotRC HT-8A transmitter (2.4 GHz FHSS, 8 ch) + F-08A receiver.** The receiver is labeled **PWM only**, 8 channels, 4–9 V input. So:
   - **#8, the PWM→PPM encoder, stays in the cart.** The flight controller takes a single serial or PPM input, not eight PWM wires (R-09).
   - Cleaner option for later: HotRC sells an **SBUS receiver for the HT-8A** ([listing](https://rcdrone.top/products/hotrc-ht-8a-2-4g-8ch-rc-transm)). It wires straight into the flight controller, needs no encoder, and is likely lighter. It isn't needed for the bench; consider it before the build if the encoder setup is fiddly.
   - Elevon mixing is done in the autopilot (ArduPlane), so the transmitter's lack of a delta mode doesn't matter. Set the transmitter to a plain 4-channel airplane model.
   - The listed radio range is about 800 m in the air. The 26 km mission is far beyond manual radio range, so the flight cards must make sure that loss of radio triggers the autopilot's return-home. This goes in the Gate 5 flight cards.
   - Weigh the F-08A on arrival of the scale: the weight budget carries 8 g for receiver + encoder (estimate).

## R-07 decision (2026-10-14, 15:25 PT): power-train lines 11-13 replaced
Full trade: `mfg/MOTOR_TRADE.md` on `r07/motor-trade` @94b96a2 (PR #14). Pending MBSE review of the airframe items (DR-14 prop notch, CG lever); the parts below don't depend on them.

| # | Item | Qty | Shop | Unit (USD) | Stock |
|---|---|---|---|---|---|
| 11 | Suppo 2204/14 1400kv motor (20 g) | 2 | [Altitude Hobbies](https://www.altitudehobbies.com/products/suppo-2204-14-1400kv-brushless-motor-park-300-equiv) | 17.59 | In stock |
| 12 | EMAX Bullet 30A ESC (3.5 g, meets MBSE 30 A floor) | 1 | [Pyrodrone](https://pyrodrone.com/products/emx-sc-1774-d-shot-bullet-series-30a-escblheli_s) (with #4, #5) | 22.80 | In stock |
| 13 | APC 8x6SF prop (7.1 g) | 3 | [ReadyMadeRC](https://www.readymaderc.com/products/details/apc-8x6-sf-prop) (with #3) | 2.78 | Only 3 left |
| 13b | APC 8x3.8SF prop (alternate) | 2 | [ReadyMadeRC](https://www.readymaderc.com/products/details/apc-8x3-8-sf-prop) | ~2.8 | Check |
| 14 | Scorpion 3 mm threaded prop adapter (M5) | 2 | [Scorpion](https://www.scorpionsystem.com/catalog/aeroplane/accessories_3/prop_adapter/PropAdapter3/) | 3.09 | In stock |
| | **Subtotal** | | | **~$80** | |

Cancelled: Specter 1404 4800KV, Bullet 20A, Gemfan 7040-3 (−$35–43). New expected total: about $300 plus shipping (~$340 all-in, five shops), inside the $500 authority.
