Z-b0101/zb-flight-model/(commit log)

2026-10-14 cleanup probe
2026-10-14 scaffold: add docs/TRACEABILITY.md
2026-10-14 Handover: program/: batch 2 (airfoil, iteration log, traceability, aero, architectures, materials, hotel load, verification matrix)
2026-10-14 MBSE: controlled CAD baseline in the repo (#1)
    * MBSE: controlled CAD baseline sources (params.json)
    * MBSE: controlled CAD baseline sources (parametric.py)
    * MBSE: controlled CAD baseline sources (build_cad.py)
    * MBSE: controlled CAD baseline sources (build_systems.py)
    * MBSE: controlled CAD baseline sources (build_all.py)
    * MBSE: controlled CAD baseline sources (verify_params.py)
    * MBSE: controlled CAD baseline sources (verify_cad.py)
    * cad/: decode sources committed as base64 (PR #1 F1)
    The seven files were stored as base64 text. This commit replaces each with
    its decoded content, unchanged. Design-section hash of params.json is
    7be168427b4d, matching the workspace baseline run.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
    [build_all.py, build_systems.py, parametric.py, verify_cad.py, verify_params.py]
2026-10-14 twin: 6-DOF mission flight to battery depletion with energy accounting (33.96 km / 71.4 min; analytic 34.23 / 72.4)
    Claude-Session: https://claude.ai/code/session_01U6y8g27GvfNaGbaCvygcNL
2026-10-14 report: address MBSE review items 2-4 (stall reconciliation, elevon limit source, mass rollup incl. joiner); brief mass to 212 g
    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
2026-10-14 Prototype roadmap v0.1 (draft for MBSE review)
    CEO ask 2026-10-14 09:28 PT. Fastest credible path to a flying sub-250 g
    prototype with Gate 4 unchanged: calibration buy, Phase 0-3 dates,
    investor milestones, CEO decisions, schedule risks.
    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
2026-10-14 Roadmap: total cost after charger on hand
    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
2026-10-14 Calibration buy cart (prices checked 2026-10-14); R-07 finding: hold motor/ESC/prop pending KV choice
    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
2026-10-14 Cart: radio identified (HotRC HT-8A + F-08A PWM-only) -> encoder stays; SBUS option noted; RC-range note for flight cards
    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
2026-10-14 Twin: 1-minute launch-to-landing flight (JSBSim 6-DOF, scripted pitch/bank controller standing in for ArduPlane)
    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
2026-10-14 Twin: generated aircraft variant and JSBSim script for the launch-to-landing run
    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
2026-10-14 Roadmap v0.2: fold MBSE review (D-29 calibration-buy class, D-30 gate re-baseline + triad failure rule, L1/L2 language, VC-28..VC-37)
    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
2026-10-14 Twin: fix washout sign in the VLM (6 deg washout was modelled as wash-in)
    Surface slope is camber + tan(twist) with twist + = nose-down; the code had minus.
    Found by the structures work (washout raised CL at fixed alpha). Regenerated
    JSBSim model, fly/mission/takeoff-landing results and the viewer bundle.
    Effect: NP 142.6 mm and SM 7.0% unchanged (twist does not enter the derivatives);
    A2 basis 30.6 -> 31.1 km, 71.7 -> 72.0 min; operational 26.3 -> 26.4 km.
    Cm0_cg -0.023 -> +0.031; cruise trim elevon -3.2 -> +1.5 deg (TE down) at 10.5 m/s,
    -5.3 -> -0.6 deg at 7.1 m/s. The twin-vs-design trim check (-4.6 deg) no longer matches.
    Launch-to-landing controller feed-forward re-trimmed (theta +3.5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
2026-10-14 Cart line 7: spar tube bought to a spec (SA-01 R1: E >= 100 GPa, strength >= 1 GPa); spare tube is the bend coupon
    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
2026-10-14 SA-01: structural and aeroelastic analysis (FE, hatch FE, aeroelastics, landing/launch/joiner/bond checks)
    Beam FE along the swept spar with twin-VLM aero + inertia loads; five load cases x three
    spar grades x web on/off; plane-stress FE of the hatch cut-out; coupled static trim, roll
    effectiveness, Theodorsen flutter screen; landing by modal impulse. Verification tests in
    tests/test_structures.py. Write-up and ranked design changes in program/STRUCTURAL_ANALYSIS.md.
    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
2026-10-14 CE item: washout 6 -> 3-4 deg (evidence + MBSE stall caveat; locked value stays 6 until CE-01/CE-02)
    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
2026-10-14 SA-01 re-run on the corrected twin (viscous section moment); washout CE item reversed (DR-02)
    Flight loads: gust root moment 0.759 -> 0.712 N.m, torque 0.124 -> 0.163; 4 g top-skin
    buckling RF 0.94 -> 1.13; landing (governing) unchanged. Roll effectiveness and flutter
    unchanged. trim2 in aeroelastic.py now carries the twin's viscous Cm correction.
    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
2026-10-14 CE item DR-01/DR-02: tip fins + 12/8 deg elevon throw in params.json; Cn-beta derived from geometry; twin on 211.9 g
    params.json design: fin_height 120, fin_chord 60, fin_x_frac 0.70, fin_t 3, fin_mass_g 1.0,
    elevon_up_deg 12, elevon_down_deg 8 (DESIGN_KEYS extended; verify_params passes). Proposed
    design hash 752301fb9dc8; controlled baseline 7be168427b4d unchanged until MBSE merges at CE-01.
    twin/lateral.py: Cn-beta = DATCOM wing-alone + Helmbold fin build-up (+0.00126..0.00146/deg
    over CL 0.17..0.6); JSBSim CY/Cl/Cn-beta and Cnr from it; typed +0.0012 retired.
    twin/perf.py: planning mass 211.9 g (MBSE O-01 gate b) + fins via mass_props(); flap
    knockdown tagged critical/uncalibrated. Asymm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
2026-10-14 VC-29 raised to >=12 up / >=8 down with hinge-moment margin (DR-02); VC-31 >= 9.1 N; VC-38 yaw stability (DR-01)
    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
2026-10-14 params.json structure block (SA-01 R1-R5) + stacked mass/CG/SM roll-up (MBSE flags 1-2)
    structure block sits outside the design hash (stays 752301fb9dc8). Mass baseline proposed
    locked at 211.9 g / 128.5 mm. Stacked SM with all changes + 17 g motor: 4.79% (below floor);
    battery +3 mm and ESC to 95 mm restore 5.92%. Motor cap ~20 g for SM >= 5.5%.
    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
2026-10-14 R-07 motor/ESC/prop trade: Suppo 2204/14 + APC 8x6SF + Bullet 30A, THR_MAX 65%; DR-14 prop-wing intersection found, TE notch sized (VLM dNP -0.98 mm); stacked SM 4.58% needs CG lever
    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
2026-10-14 Cart: R-07 power-train lines (Suppo 2204/14, Bullet 30A, APC 8x6SF, 3 mm adapter); ref r07/motor-trade @94b96a2
    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
2026-10-14 CAD toolchain without PyPI: Manifold kernel from git source + CadQuery-API shim; repo CAD scripts run unchanged (CG 128.5 mm / 209.0 g match record; verify_cad all pass; 37/37 parts watertight)
    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
2026-10-14 CAD env: real CadQuery 2.8.0 now installs (registries enabled); --real setup path with NO_PROXY workaround; shim cross-check max 0.23% volume diff
    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
2026-10-14 MASS_ROLLUP: sensitivity table regenerated from script (NP 142.56 mm, MBSE nit); cap stated <=19 g; R-07 full-stack supersession noted
    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
2026-10-14 CE-01 decision C (CEO): CG layout lever FC 5 mm fwd + battery 9 mm fwd (FC +10 clashes the spar); real-CadQuery build 0 CLASH/0 TIGHT, verify all pass; stacked SM 5.63%
    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
    [build_systems.py]
2026-10-14 CE-01 DESIGN FREEZE (CEO, 2026-10-14): hash 479399d88b60; 233.0 g, CG 130.32 mm, SM 5.66%; DR-14 notch in params/VLM/CAD + prop-disc clash check; fixed inboard TE part; structures re-run at frozen ma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
    Merges PR #10, #12, #13 (MBSE approved), #14 (CEO approved). Record: program/CE-01_FREEZE.md
    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
    [build_all.py, build_systems.py, parametric.py]
2026-10-15 CE-02 (proposed): live digital-twin link — mLRS 900 MHz RC+MAVLink, onboard-wireless bench link, twin shadow-mode bridge; -2.7 g, RX forward for SM
    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
2026-10-15 CE-02 Rev A: re-optimised for design (CEO 19:48): ELRS LR1121 RX (~1.8 g, ~0.4 W) recommended over mLRS; -6.2 g net; RX at x<=60 mm for SM>=5.5%; ground kit Nomad + EdgeTX handset
    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
2026-10-15 Constitution DRAFT v0.1 (Claude) for joint drafting with Oubi; ratification target 06:00 PT
    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
2026-10-15 Constitution Amendment 3: Senior Technical Fellow seat, staged design hand-down, handover notes (CEO approved Art I.2)
